louhui-hello/ESP32-S3_Clock/docs/README.md

# 文档 · Documentation

这个目录放的是**说明性文档**，不是设计文件。
Narrative documentation — not design files.

---

## 文件索引 · Index

| 文件 / File | 内容 / Content |
|---|---|
| [versions.md](versions.md) | 板子版本演进（V1 → V3.0） |
| [soldering.md](soldering.md) | 焊接顺序、热板参数、检查清单 |
| `images/` | 3D 渲染、实物照、原理图截图 |

---

## 待补 · TODO

- [ ] V2 的记录（如果有）
- [ ] 引脚定义表 `pinout.md`
- [ ] 电源设计说明 `power.md`
- [ ] 第一次上电的测试记录
- [ ] `images/` 里的图片

---

## 写文档的约定 · Conventions

```
✅ 中英双语，先中后英
✅ 每条建议都写理由，不只写"推荐"
✅ 已知问题写成表格，带"计划"
✅ 图片放 images/，用相对路径引用
```
