louhui-hello/ESP32-S3_Clock/docs/versions.md

# 版本演进 · Version History

板子本体的迭代记录，不是文件格式版本。
Board revisions — not file format versions.

---

## 总览 · Overview

| 板子版本 / Board | 主控 / MCU | 层数 | 关键变化 / Key Change | 状态 |
|---|---|---|---|---|
| V1 | STC15 | 2 | 第一版 | ❌ 文件已丢失 |
| V1.5 | ESP8266（ESP-12F） | 2 | 换成 WiFi 方案 | ✅ 有仿真图 |
| V2 | ? | ? | 待补 | ❓ |
| **V3.0** | **ESP32-S3-WROOM-1** | **4** | **加充电 + 降压 + 电池** | ✅ **当前** |

> ⚠️ 注意区分：`hardware/Project_Files/Project_EasyEDA/v2` 和 `v3` 是**文件格式**，
> 不是板子版本。两份内容相同，只是 `.epro` 与 `.epro2` 两种容器。

---

## V3.0（2026-10-17 下单）

**关键变化**

- 主控升级为 **ESP32-S3-WROOM-1-N16R8**
- 从 2 层升到 **4 层**，叠层改为 信号 / GND / 3V3 / 信号
- 电源链完整化：**TP4056 充电 + TLV62568 降压**
  - 替换掉旧方案的 AMS1117（压差大、静态电流高）
- 增加 **CR1220 备电**，RTC 掉电不丢时间
- 增加 **AT24C02**，存闹钟和配置
- 板载 **无源蜂鸣器**（PWM 驱动）
- 4 键 + RST + BOOT
- TP4056 加 **散热焊盘 + 6 个散热过孔**

**交付参数**

- 尺寸 81.915 × 72.263 mm
- 4 层，1.6 mm，OSP，蓝色阻焊
- DRC 0 错误

**生产记录**

| 步骤 | 时间 |
|---|---|
| 下单 | 2026-10-17 02:14 |
| 层压 | 2026-10-17 23:23 |
| 钻孔 | 2026-10-18 04:51 |
| 沉铜 | 2026-10-18 06:07 |
| 预计发货 | 2026-10-20 |

**上电实测（2026-10-26）**

| 项目 | 结果 | 说明 |
|---|---|---|
| I2C 扫描 | 0x3C / 0x50 / 0x68 | OLED、AT24C02、DS3231 全部响应 |
| DS3231 | ✅ 正常 | 片内温度 30.75 °C，秒寄存器递增 |
| RTC 时间 | ❌ 未设置 | 读回 2000-01-01，状态寄存器 OSF=1 |
| CR1220 备电 | ❌ 待修 | 电池座负极下方缺 GND 铺铜，电池短路鼓包，重新购买 |

> 测试工具：`tools/i2c_scan`（总线扫描）、`tools/rtc_probe`（RTC 识别 + 走时检测）。

---

## V1.5（2026-10-12 下单）

**方案**

- ESP8266（ESP-12F 模组）
- 2 层板，绿色阻焊
- 3 个 LED、3 个按键
- 一个圆形电池座
- 4P 排针（外接 OLED）
- 2P 排针

**板号**：`13226789A_Y6_261012`

**局限**

- 无板上显示，OLED 靠排针外接
- 无充电管理
- 无 RTC

---

## V1（已丢失）

- STC15 方案
- 2 层板
- 细节已无法考证

---

## 待办 · TODO

- [ ] 补 V2 的记录
- [ ] 补 V1 的照片（如果有）
- [ ] 每版存一张 3D 渲染图到 `docs/images/`
