louhui-hello/ESP32-S3_Clock/tools/README.md

# 工具 · Tools

辅助脚本，不是项目本体。
Helper scripts — not part of the firmware or hardware.

---

## 目录 · Contents

```
tools/
└── flash_tools/     烧录相关 / flashing helpers
```

---

## TODO

- [ ] ESP-IDF 一键构建 + 烧录脚本
- [ ] 串口日志抓取脚本
- [ ] 量产测试脚本

---

## 说明 · Note

这里的脚本默认 **不依赖第三方库**，能跑就行。
Scripts here should stay dependency-free.
