louhui-hello/ESP32-S3_Clock/legacy/old_repo/docs/README.md

<!--
文档与图片：Copyright (C) 2026 louhui, licensed under CC-BY-SA-4.0
-->

# docs

- `images/` ：原理图、PCB、实物照片
