louhui-hello/ESP32-S3_Clock/hardware/PCB/BOM/BOM_Board1_Schematic1_2026-10-18.xlsx

No. | Quantity | Comment | Designator | Footprint | Value | Manufacturer Part | Manufacturer | Supplier Part | Supplier
1 | 1 | AT24C02 | AT24C02_EEPROM | SOP-8_L5.0-W4.0-P1.27-LS6.0-BL |  | AT24C02 | IDCHIP(英锐芯) | C688857 | LCSC
2 | 1 | LAIL-CR1220-MO-02 | BT1 | BAT_TH_LAIL-CR1220-MO-02 |  | LAIL-CR1220-MO-02 | LAILAN(莱联) | C55318146 | LCSC
3 | 2 | 22uF | C1,C9 | C1210 | 22uF | CL32A226KAJNNNE | SAMSUNG(三星) | C52306 | LCSC
4 | 3 | 100nF | C2,C4,C7 | C0805 | 100nF | CL21B104KBCNNNC | SAMSUNG(三星) | C1711 | LCSC
5 | 1 | 22uF | C3 | C0805 | 22uF | HGC0805R5226M250NSLJ | Chinocera(华瓷) | C33546009 | LCSC
6 | 3 | 100nF | C5,C6,C8 | C0805 | 100nF | CC0805KRX7R9BB104 | YAGEO(国巨) | C49678 | LCSC
7 | 2 | 10uF | C10,C11 | C0805 | 10uF | CL21A106KAYNNNE | SAMSUNG(三星) | C15850 | LCSC
8 | 1 | 1N4148W | D1 | SOD-123_L2.7-W1.6-LS3.7-FD |  | 1N4148W | R+O(宏嘉诚) | C7420318 | LCSC
9 | 1 | SS34 | D2 | SMC_L6.9-W5.9-LS7.9-RD |  | SS34 | onsemi(安森美) | C154551 | LCSC
10 | 1 | LAIL-PZ2.54-3P-L | H1 | HDR-TH_3P-P2.54-V-M-1 |  | LAIL-PZ2.54-3P-L | LAILAN(莱联) | C54950604 | LCSC
11 | 1 | LAIL-PZ2.54-4P-L | H2 | CONN-TH_LAIL-PZ2.54-4P-L |  | LAIL-PZ2.54-4P-L | LAILAN(莱联) | C54950602 | LCSC
12 | 1 | DH0520H-2R2M | L1 | IND-SMD_L5.6-W5.2_MST0530H-150M |  | DH0520H-2R2M | DH(德鸿感应) | C41407019 | LCSC
13 | 1 | GL0805UG01 | LED3 | LED0805-FD_GL0805UG01 |  | GL0805UG01 | Guiguang light(桂光光电) | C51933308 | LCSC
14 | 1 | GL0805UR01 | LED4 | LED0805-R-RD_RED |  | GL0805UR01 | Guiguang light(桂光光电) | C51933307 | LCSC
15 | 1 | MicroXNJ | MicroUSB | MICRO-USB-SMD_MICROXNJ_1 |  | MicroXNJ | SHOU HAN(首韩) | C404969 | LCSC
16 | 1 | ZX-MX1.25-2PWZ | MX1.25电池连接器 | CONN-TH_2P-P1.25_ZX-MX1.25-2PWZ |  | ZX-MX1.25-2PWZ | Megastar(兆星) | C7430463 | LCSC
17 | 1 | S8050 | Q1 | SOT-23-3_L2.9-W1.3-P1.90-LS2.3-BR |  | S8050 | R+O(宏嘉诚) | C20069125 | LCSC
18 | 1 | AO3401A | Q2 | SOT-23_L2.9-W1.3-P1.90-LS2.4-BR |  | AO3401A | AOS | C15127 | LCSC
19 | 4 | 10kΩ | R1,R2,R3,R5 | R0603 | 10kΩ | FRC0603F1002TS | FOJAN(富捷) | C2906982 | LCSC
20 | 2 | 0Ω | R6,R16 | R1206 | 0Ω | RE1206F1R000 | JIERR(捷而瑞) | C46961765 | LCSC
21 | 2 | 4.7kΩ | R7,R8 | R0603 | 4.7kΩ | 0603WAF4701T5E | UNI-ROYAL(厚声) | C23162 | LCSC
22 | 1 | 2.4kΩ | R9 | R0603 | 2.4kΩ | FRC0603F2401TS | FOJAN(富捷) | C2907007 | LCSC
23 | 2 | 100kΩ | R10,R14 | R0805 | 100kΩ | 0805W8F1003T5E | UNI-ROYAL(厚声) | C149504 | LCSC
24 | 1 | 22kΩ | R11 | R0805 | 22kΩ | FRC0805F2202TS | FOJAN(富捷) | C2907243 | LCSC
25 | 2 | 1kΩ | R12,R13 | R0805 | 1kΩ | 0805W8F1001T5E | UNI-ROYAL(厚声) | C17513 | LCSC
26 | 1 | 1kΩ | R15 | R0603 | 1kΩ | FRC0603F1001TS | FOJAN(富捷) | C2907002 | LCSC
27 | 5 | TS-1101-C-W | SW2,SW3,SW4,SW5,SW6 | SW-SMD_L6.0-W3.3-LS8.0_TS-1101-C-W |  | TS-1101-C-W | XKB Connection(中国星坤) | C318938 | LCSC
28 | 1 | TLV62568DBVR | TLV62568_BUCK | SOT-23-5_L3.0-W1.7-P0.95-LS2.8-BR |  | TLV62568DBVR | TI(德州仪器) | C163219 | LCSC
29 | 1 | TP4056 | TP4056 | ESOP-8_L4.9-W3.9-P1.27-LS6.0-BL-EP |  | TP4056 | UMW(友台半导体) | C725790 | LCSC
30 | 1 | 2.4GHz | U2 | WIRELM-SMD_ESP32-S3-WROOM-1 | 2.4GHz | ESP32-S3-WROOM-1-N16R8 | ESPRESSIF(乐鑫) | C2913202 | LCSC
31 | 1 | DS3231MZ+TRL | U3 | SOIC-8_L4.9-W3.9-P1.27-LS6.0-BL |  | DS3231MZ+TRL | ADI(亚德诺)/MAXIM(美信) | C107410 | LCSC
32 | 1 | LAIL-PM2.54-4P-L | U4 | HDR-TH_4P-P2.54-V-F |  | LAIL-PM2.54-4P-L | LAILAN(莱联) | C54973823 | LCSC
33 | 1 | 2.7kHz | 无源蜂鸣器 | BUZ-TH_BD9.0-P4.00-D0.6-FD | 2.7kHz | QMB-09B-03 | 华能 | C96256 | LCSC
