louhui-hello/ESP32-S3_Clock/legacy/old_repo/hardware/BOM.md

# 物料清单 BOM — ESP32-S3 桌面闹钟 V3.0

> **数据来源**：立创商城订货合同 `SO2610171717`（2026-10-17，甲方：娄辉）
> **采购分两处**：主控模组走淘宝（立创无货且淘宝更便宜），其余全部立创商城。

---

## 一、立创商城下单明细（32 项，实际成交价）

| # | 型号 | 封装 | 参数 | 数量 | 立创编号 | 位号 | 金额(¥) |
|---|---|---|---|---|---|---|---|
| 1 | **0603WAF4701T5E** | 0603 | 4.7kΩ ±1% 100mW | 100 | C23162 | R7 R8 | 1.62 |
| 2 | **TP4056** | ESOP-8 | 1A 线性锂电充电器 | 5 | C725790 | U6 | 2.73 |
| 3 | **CL21A106KAYNNNE** | 0805 | 10µF ±10% 25V | 20 | C15850 | C10 C11 | 5.16 |
| 4 | **LAIL-PZ2.54-4P-L** | 插件 | 1x4P 2.54mm 方针 | 20 | C54950602 | H2 | 4.55 |
| 5 | **MicroXNJ** | SMD | Micro-B 母座 卧贴 | 10 | C404969 | USB1 | 2.52 |
| 6 | **SS34** | SMC | 40V 3A 肖特基 | 1 | C154551 | D2 | 3.45 |
| 7 | **RE1206F1R000** | 1206 | 0Ω 1W ±1% | 10 | C46961765 | R6 R16 | 3.04 |
| 8 | **CL32A226KAJNNNE** | 1210 | 22µF ±10% 25V | 2 | C52306 | C1 C9 | 2.88 |
| 9 | **TLV62568DBVR** | SOT-23-5 | 降压 1A 2.5~5.5V | 5 | C163219 | U7 | 2.24 |
| 10 | **1N4148W** | SOD-123 | 100V 150mA | 50 | C7420318 | D1 | 2.08 |
| 11 | **HGC0805R5226M250NSLJ** | 0805 | 22µF ±20% 25V | 5 | C33546009 | C3 | 4.24 |
| 12 | **FRC0603F1002TS** | 0603 | 10kΩ ±1% 100mW | 100 | C2906982 | R1 R2 R3 R5 | 1.11 |
| 13 | **AO3401A** | SOT-23 | P沟道 30V 4A | 5 | C15127 | Q2 | 3.00 |
| 14 | **0805W8F1001T5E** | 0805 | 1kΩ ±1% 125mW | 100 | C17513 | R12 R13 | 2.02 |
| 15 | **GL0805UR01** | 0805 | 红色 高亮 | 100 | C51933307 | LED4 | 2.92 |
| 16 | **FRC0603F1001TS** | 0603 | 1kΩ ±1% 100mW | 100 | C2907002 | R15 | 1.18 |
| 17 | **GL0805UG01** | 0805 | 翠绿 高亮 | 100 | C51933308 | LED3 | 2.94 |
| 18 | **FRC0805F2202TS** | 0805 | 22kΩ ±1% 125mW | 100 | C2907243 | R11 | 1.79 |
| 19 | **LAIL-PM2.54-4P-L** | 插件 | 1x4P 2.54mm | 5 | C54973823 | U4 | 3.24 |
| 20 | **ZX-MX1.25-2PWZ** | 插件 | 1x2P 1.25mm 弯插 | 50 | C7430463 | U8 | 4.09 |
| 21 | **CL21B104KBCNNNC** | 0805 | 100nF ±10% 50V | 20 | C1711 | C2 C4 C7 | 1.78 |
| 22 | **S8050** | SOT-23 | NPN 500mA 25V | 50 | C20069125 | Q1 | 3.53 |
| 23 | **QMB-09B-03** | 插件 D9mm | 无源蜂鸣器 | 5 | C96256 | BUZZER1 | 3.86 |
| 24 | **DH0520H-2R2M** | SMD 5.6x5.2 | 2.2µH 屏蔽电感 | 5 | C41407019 | L1 | 2.55 |
| 25 | **LAIL-CR1220-MO-02** | 插件 | CR1220 电池扣 | 5 | C55318146 | BT1 | 5.84 |
| 26 | **AT24C02** | SOP-8 | 2Kbit EEPROM | 10 | C688857 | U5 | 3.91 |
| 27 | **CC0805KRX7R9BB104** | 0805 | 100nF ±10% 50V | 20 | C49678 | C5 C6 C8 | 2.41 |
| 28 | **LAIL-PZ2.54-3P-L** | 插件 | 1x3P 2.54mm 方针 | 20 | C54950604 | H1 | 3.64 |
| 29 | **TS-1101-C-W** | SMD 6x3.6 | 轻触开关 立贴 | 10 | C318938 | SW2~SW6 | 2.59 |
| 30 | **DS3231MZ+TRL** | SOIC-8 | 高精度 RTC | 1 | C107410 | U3 | 20.84 |
| 31 | **FRC0603F2401TS** | 0603 | 2.4kΩ ±1% 100mW | 100 | C2907007 | R9 | 1.25 |
| 32 | **0805W8F1003T5E** | 0805 | 100kΩ ±1% 125mW | 100 | C149504 | R10 R14 | 3.46 |
| | | | | | | **商品合计（含税）** | **112.46** |
| | | | | | | 运费 | 8.00 |
| | | | | | | **订单总计** | **120.46** |

> **说明**：立创商城对个人买家按 13% 增值税计价（未税 99.52 + 税 12.94 = 112.46）。
> 上表金额为**含税实付**。

### 最小包装说明

立创对小批量有最小包装，很多东西一买就是 100 个：

| 类别 | 最小包装 | 实际用量 |
|---|---|---|
| 0603 / 0805 电阻 | **100 个** | 1~4 个 |
| 0402~0805 电容 | 20 个 | 2~3 个 |
| LED | **100 个** | 1 个 |
| 二极管 / 三极管 | 50 个 | 1 个 |
| 排针 / 连接器 | 20 个 | 1 个 |

**多出来的全是备件**，以后做别的板子能接着用，不是浪费。

---

## 二、淘宝待买

| 项目 | 型号 | 数量 | 单价(¥) | 小计(¥) | 说明 |
|---|---|---|---|---|---|
| **主控模组** | **ESP32-S3-WROOM-1-N16R8** | 1 | **22.00** | **22.00** | 立创商城 C2913202 配单无匹配，走淘宝「优信电子」 |
| OLED 屏 | 0.91 寸 128×32 I2C（SSD1306） | 1 | 约 8.00 | 8.00 | |
| RTC 电池 | CR1220（3V 锂锰，**不可充**） | 1 | 约 2.00 | 2.00 | |
| 主电池 | 软包锂电 1000mAh（带保护板，MX1.25 插头） | 1 | 约 12.00 | 12.00 | 503450 尺寸 |
| | | | | **约 ¥44** | 另计运费 |

> **电池可以延后买**：调试阶段只插 USB 就能跑，等板子验证通过再买电池。

---

## 三、总账

| 项目 | 金额(¥) |
|---|---|
| 立创商城（32 项，含税 + 运费） | 120.46 |
| 淘宝（S3 模组 + OLED + 电池） | 约 44.00 |
| 淘宝运费 | 约 5.00 |
| **PCB 打样（4 层 ×5 片，OSP 券免费）** | **0.00** |
| **合计** | **约 ¥169** |

**其中"必须花"的：**
- DS3231（¥20.84）+ EPS32-S3（¥22）= **¥42.84**，占 25%
- 这两颗是项目核心，**不能省**

**可以延后的：**
- 软包电池 ¥12 + CR1220 ¥2 = ¥14（调试阶段用 USB 供电）

---

## 四、位号对照表（原理图 → 实物）

| 位号 | 型号 | 作用 |
|---|---|---|
| **U2** | ESP32-S3-WROOM-1-N16R8 | 主控 |
| **U3** | DS3231MZ+TRL | 高精度 RTC |
| **U5** | AT24C02 | 2Kbit EEPROM（存设置） |
| **U6** | TP4056 | 锂电池充电 |
| **U7** | TLV62568DBVR | 3.3V 降压（buck） |
| **U8** | ZX-MX1.25-2PWZ | 电池连接器（卧式弯针） |
| **U4** | LAIL-PM2.54-4P-L | OLED 排针 |
| **H1** | LAIL-PZ2.54-3P-L | UART 排针 |
| **H2** | LAIL-PZ2.54-4P-L | I2C 扩展排针 |
| **Q1** | S8050 | 蜂鸣器驱动（NPN） |
| **Q2** | AO3401A | 负载分配（P-MOS） |
| **D1** | 1N4148W | 蜂鸣器续流二极管 |
| **D2** | SS34 | USB 通路 + 防倒灌 |
| **L1** | DH0520H-2R2M | buck 储能电感 2.2µH |
| **BT1** | CR1220 电池扣 | RTC 后备电池 |
| **BUZZER1** | QMB-09B-03 | **无源**蜂鸣器（需 PWM 驱动） |
| **LED3 / LED4** | GL0805UG01 / GL0805UR01 | 绿=满电 / 红=充电中 |
| **SW2~SW6** | TS-1101-C-W | BOOT / 三按键 / RST |
| **USB1** | MicroXNJ | Micro-USB 座 |
| R1 R2 R3 R5 R9 R15 | 10k / 2.4k / 1k | 上拉、PROG、基极限流 |
| R10 R11 R14 | 100k / 22k / 100k | buck 分压、栅极下拉 |
| R12 R13 | 1kΩ | LED 限流 |
| R6 R16 | 0Ω | RTC 串联 / 电池电流测试点 |
| R7 R8 | 4.7kΩ | I2C 上拉 |

---

## 五、关键设计参数（V3.0）

| 项 | 值 |
|---|---|
| 板框 | 81.91 × 72.26 mm，四角圆角 R3 |
| 叠层 | **4 层**：信号 / GND / 3.3V / 信号 |
| 铜厚 | 外层 1oz，内层 0.5oz |
| 工艺 | OSP（免清洗） |
| 最小孔径 | 0.3 mm |
| 走线 | 424 段，全在顶层 |
| 过孔 | 86 个 |
| **DRC** | **0 错误** |

### 供电架构

```
USB 5V ── VBUS ──┬── U6 TP4056 ── 电池
                 ├── D2 (SS34) ──┐
                 └── Q2 栅极      │
   电池 ──────── Q2 (AO3401) ─────┴── VIN ── U7 buck ── 3.3V
```

**特性**：USB 和电池自动切换；充电时电池被隔离（不会边充边放）；深睡约 20µA。

---

## 六、给家长看的三个重点

1. **PCB 免费**：有「2~6 层 OSP 免费」券，正常 4 层 5 片要 ¥50，这次 **0 元**；
2. **不量产、不上 SMT**：自己做 **5 片**，全部手焊，**省掉约 ¥50 的贴片费**；
3. **有一大半是备件**：立创按最小包装卖（电阻 100 只、排针 20 根…），用不完的下次继续用。
