louhui-hello/ESP32-S3_Clock/hardware/STEP/README.md

# 3D 模型 · 3D Model

给外壳设计用的 STEP 文件。
STEP files for enclosure design.

---

## 状态 · Status

> 🚧 待补 — 从立创EDA 导出后放这里。
> 🚧 TODO — export from EasyEDA Pro and drop the file here.

---

## 如何导出 · How to Export

```
立创EDA Pro → 打开工程 → 文件 → 导出 → STEP
→ 存成 esp32s3_clock_v3.step
```

---

## 外壳尺寸参考 · Enclosure Reference

```
PCB:      81.9 × 72.3 × 1.6 mm
最高元件:  约 6 mm（背面）
21700:     Ø21 × 70 mm（含保护板 Ø23.5）

建议外壳内腔: 85 × 75 × 35 mm
```
