louhui-hello/ESP32-S3_Clock/hardware/PCB/PCB_PCB1_2026-10-18.pdf

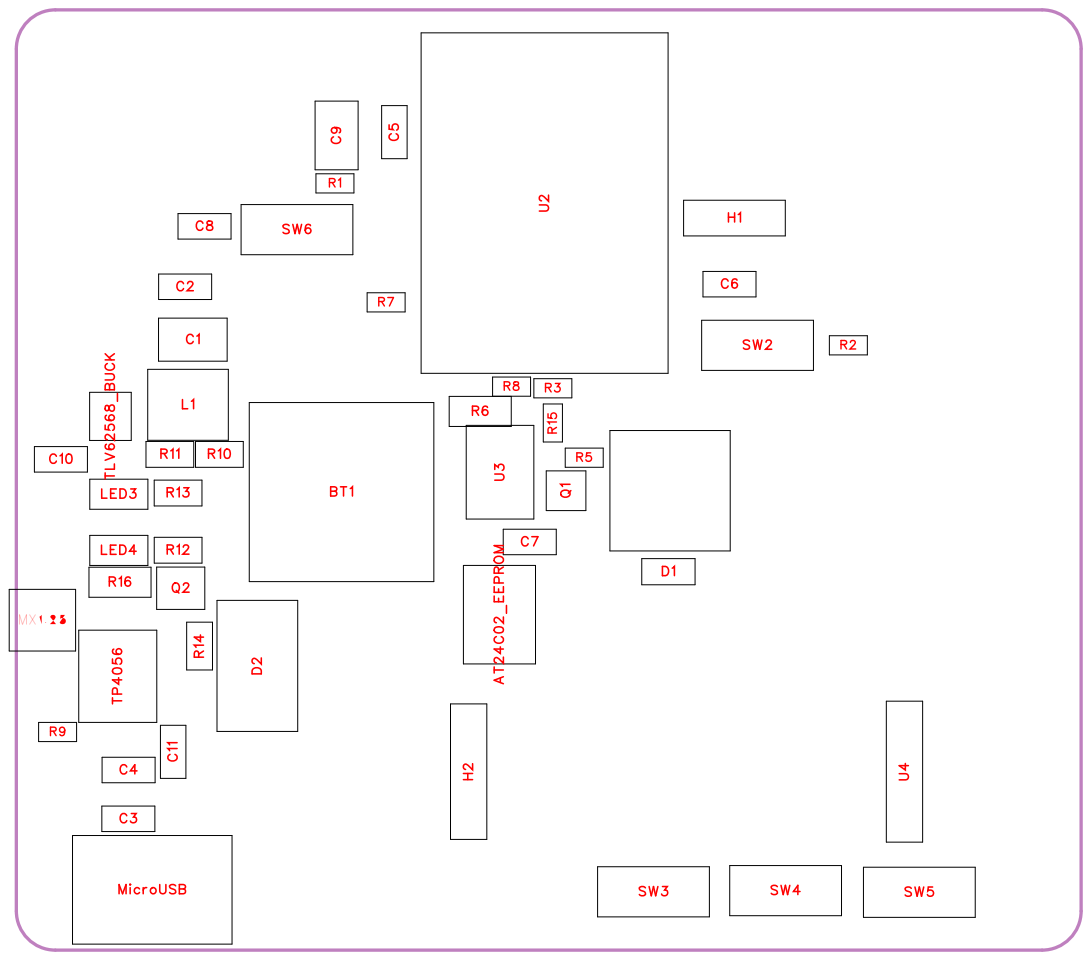
[picture p1: page 1]

No. | Quantity | Comment | Designator | Footprint | Value | Manufacture r Part | Manufacture r | Supplier Part | Supplier
1 | 1 | AT24C02 | AT24C02_EEPROM | SOP-8_L5.0-W4.0-P1.27-LS6.0-BL | | AT24C02 | IDCHIP(ñ¯) | C688857 | LCSC
2 | 1 | LAIL-CR1220 -MO-02 | BT1 | BAT_TH_LAIL -CR1220-MO-02 | | LAIL-CR1220 -MO-02 | LAILAN(±T) | C55318146 | LCSC
3 | 2 | 22uF | C1,C9 | C1210 | 22uF | CL32A226KAJ NNNE | SAMSUNG( ) C52306 | | LCSC
4 | 3 | 100nF | C2,C4,C7 | C0805 | 100nF | CL21B104KBC NNNC | SAMSUNG( ) C1711 | | LCSC
5 | 1 | 22uF | C3 | C0805 | 22uF | HGC0805R522 6M250NSLJ | Chinocera(N) Tj | T* (÷) C33546009 | LCSC
6 | 3 | 100nF | C5,C6,C8 | C0805 | 100nF | CC0805KRX7R 9BB104 | YAGEO(ýè) | C49678 | LCSC
7 | 2 | 10uF | C10,C11 | C0805 | 10uF | CL21A106KAY NNNE | SAMSUNG( ) C15850 | | LCSC
8 | 1 | 1N4148W | D1 | SOD-123_L2. 7-W1.6-LS3. 7-FD | | 1N4148W | R+O(• Ú) | C7420318 | LCSC
9 | 1 | SS34 | D2 | SMC_L6.9-W5 .9-LS7.9-RD | | SS34 | onsemi(‰îŽ) | C154551 | LCSC
10 | 1 | LAIL-PZ2.54 -3P-L | H1 | HDR-TH_3P-P 2.54-V-M-1 | | LAIL-PZ2.54 -3P-L | LAILAN(±T) | C54950604 | LCSC
11 | 1 | LAIL-PZ2.54 -4P-L | H2 | CONN-TH_LAI L-PZ2.54-4P -L | | LAIL-PZ2.54 -4P-L | LAILAN(±T) | C54950602 | LCSC
12 | 1 | DH0520H-2R2 M | L1 | IND-SMD_L5. 6-W5.2_MST0 530H-150M | | DH0520H-2R2 M | DH(·?”) | C41407019 | LCSC
13 | 1 | GL0805UG01 LED3 | | LED0805-FD_ GL0805UG01 | | GL0805UG01 | Guiguang light(BII5) | C51933308 | LCSC
14 | 1 | GL0805UR01 | LED4 | LED0805-R-R D_RED | | GL0805UR01 | Guiguang light(BII5) | C51933307 | LCSC
15 | 1 | MicroXNJ | MicroUSB | MICRO-USB-S MD_MICROXNJ _1 | | MicroXNJ | SHOU HAN(–é) | C404969 | LCSC
16 | 1 | ZX-MX1.25-2 PWZ | MX1.255`Þ¥h | CONN-TH_2P-P1.25_ZX-MX 1.25-2PWZ | | ZX-MX1.25-2 PWZ | Megastar(F) Tj | T* () C7430463 | LCSC
17 | 1 | S8050 | Q1 | SOT-23-3_L2 .9-W1.3-P1. 90-LS2.3-BR | | S8050 | R+O(• Ú) | C20069125 | LCSC
18 | 1 | AO3401A | Q2 | SOT-23_L2.9 -W1.3-P1.90 -LS2.4-BR | | AO3401A | AOS | C15127 | LCSC
19 | 4 | 10k© | R1,R2,R3,R5 | R0603 | 10k© | FRC0603F100 2TS | FOJAN(Ìw) | C2906982 | LCSC

20 | 2 | 0© | R6,R16 | R1206 | 0© | RE1206F1R00 0 | JIERR(w^) | C46961765 | LCSC
21 | 2 | 4.7k© | R7,R8 | R0603 | 4.7k© | 0603WAF4701 T5E | UNI-ROYAL(š) Tj | T* (ð) C23162 | LCSC
22 | 1 | 2.4k© | R9 | R0603 | 2.4k© | FRC0603F240 1TS | FOJAN(Ìw) | C2907007 | LCSC
23 | 2 | 100k© | R10,R14 | R0805 | 100k© | 0805W8F1003 T5E | UNI-ROYAL(š) Tj | T* (ð) C149504 | LCSC
24 | 1 | 22k© | R11 | R0805 | 22k© | FRC0805F220 2TS | FOJAN(Ìw) | C2907243 | LCSC
25 | 2 | 1k© | R12,R13 | R0805 | 1k© | 0805W8F1001 T5E | UNI-ROYAL(š) Tj | T* (ð) C17513 | LCSC
26 | 1 | 1k© | R15 | R0603 | 1k© | FRC0603F100 1TS | FOJAN(Ìw) | C2907002 | LCSC
27 | 5 | TS-1101-C-W SW2,SW3,SW4,SW5,SW6 | | SW-SMD_L6.0 -W3.3-LS8.0 _TS-1101-C-W | | TS-1101-C-W | XKB Connect ion(-ýd) | C318938 | LCSC
28 | 1 | TLV62568DBV R | TLV62568_BUCK | SOT-23-5_L3 .0-W1.7-P0. 95-LS2.8-BR | | TLV62568DBV R | TI(·Þêh) | C163219 | LCSC
29 | 1 | TP4056 | TP4056 | ESOP-8_L4.9 -W3.9-P1.27 -LS6.0-BL-E P | | TP4056 | UMW(ËðJüS) | C725790 | LCSC
30 | 1 | 2.4GHz | U2 | WIRELM-SMD_ ESP32-S3-WR OOM-1 | 2.4GHz | ESP32-S3-WR OOM-1-N16R8 | ESPRESSIF(P) Tj | T* (k) C2913202 | LCSC
31 | 1 | DS3231MZ+TR L | U3 | SOIC-8_L4.9 -W3.9-P1.27 -LS6.0-BL | | DS3231MZ+TR L | ADI(š·ú)/MA XIM(Žá) | C107410 | LCSC
32 | 1 | LAIL-PM2.54 -4P-L | U4 | HDR-TH_4P-P 2.54-V-F | | LAIL-PM2.54 -4P-L | LAILAN(±T) | C54973823 | LCSC
33 | 1 | 2.7kHz | à•-#h | BUZ-TH_BD9. 0-P4.00-D0. 6-FD | 2.7kHz | QMB-09B-03 | Ný | C96256 | LCSC

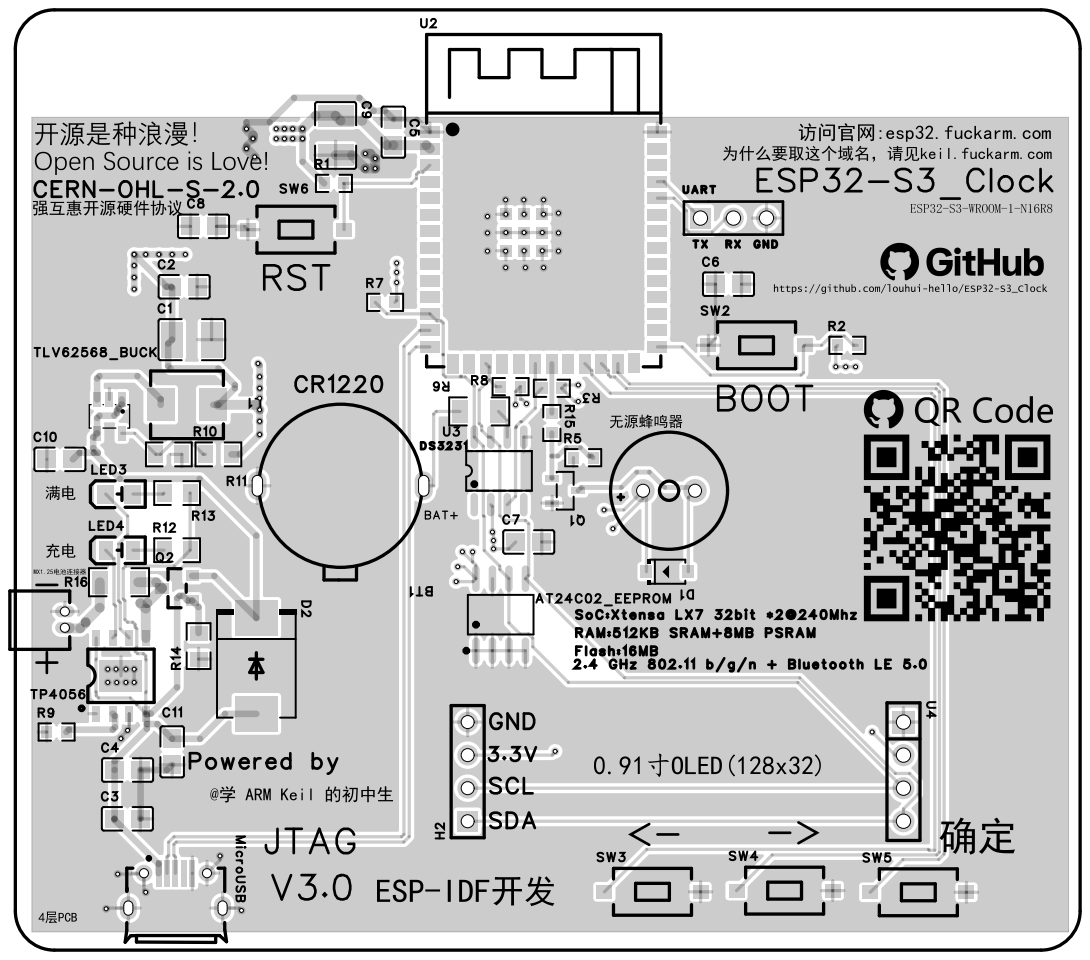
[picture p2: page 5]

Open Source is Love!
CERN-OHL-S-2.0
:àlöOfi

https://github.com/louhui-hello/ESP32-S3_Clock

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

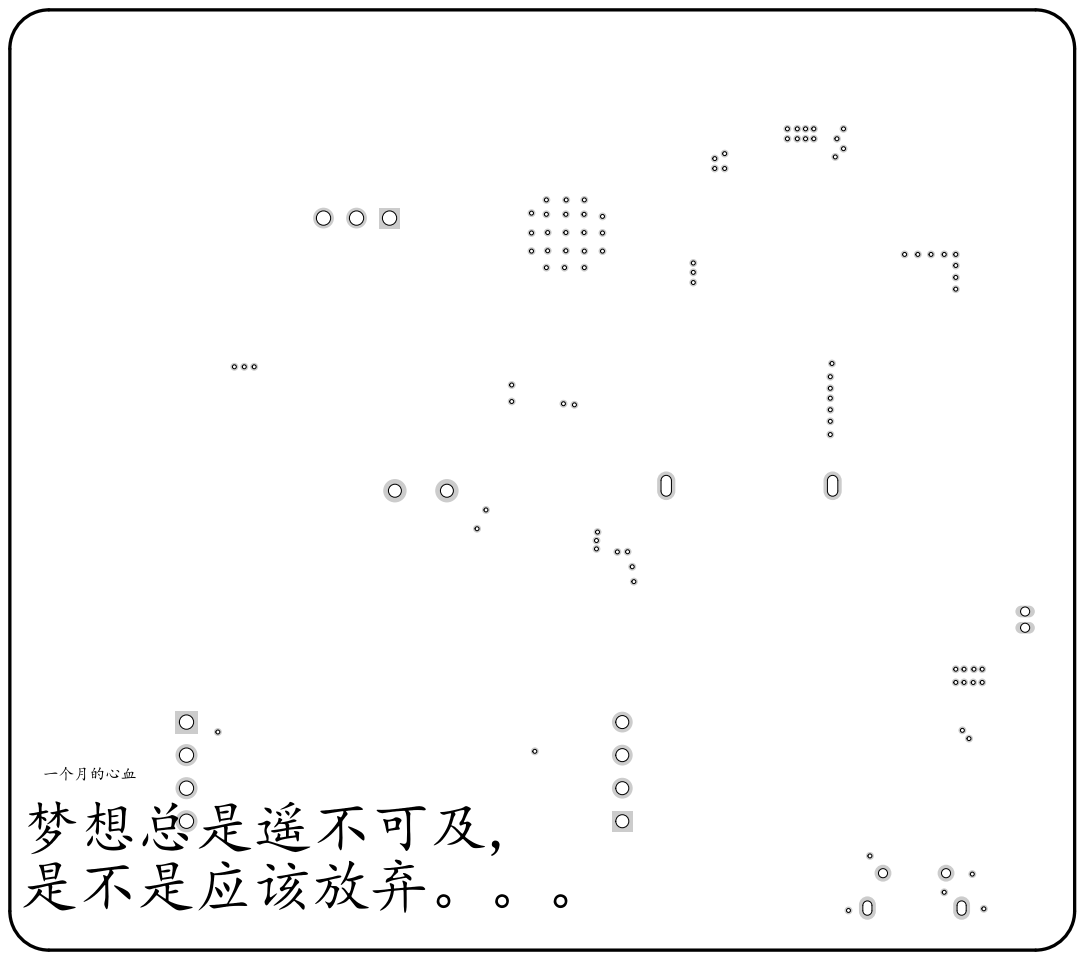
[picture p3: page 6]

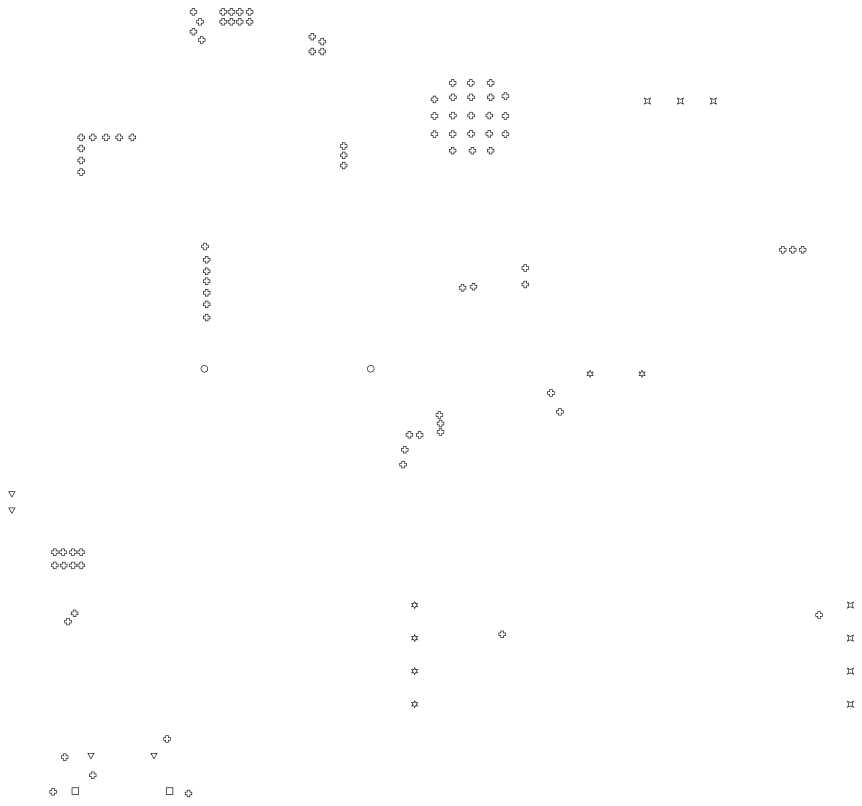
[picture p4: page 7]
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
