louhui-hello/ESP32-S3_Clock/(list of files, drawings)

Other design files:
hardware/Project_Files/Project_EasyEDA/v2/ProPrj_ESPRESSIF32-S3_CLOCK_BAT_2026-10-18.epro
