louhui-hello/ESP32-S3_Clock/(commit log)

2026-10-18 初始化仓库：V3.0 文档、硬件资料、固件占位 / init: V3.0 docs, hardware files, firmware placeholder
    [BOM_Board1_Schematic1_2026-10-18.xlsx, ProPrj_ESPRESSIF32-S3_CLOCK_BAT_2026-10-18.epro]
2026-10-18 新增 legacy/ 目录：旧版本存档 / add legacy/ for archived revisions
2026-10-18 用 .gitkeep 占位空目录 / keep empty dirs with .gitkeep
2026-10-18 legacy/ 加入旧仓库快照 open_repo / archive old open_state repo under legacy/
    [BOM.csv, BOM_立创商城_ESP32-S3_Clock.xlsx]
2026-10-18 tools: 加入 ESP32 烧录器（Qt6/QML 单文件版 + 源码）与 bin 合并脚本
2026-10-24 tools/oled_rtc: u8g2 时钟固件（NTP 对时 + 按键闹钟 + 网页上传 MIDI 旋律 + 蜂鸣器）
2026-10-24 docs: 添加英文版 README（完整硬件/固件/API/已知问题/路线图）
2026-10-26 tools: 新增 I2C 扫描与 RTC 探针（验证 0x3C/0x50/0x68 与 DS3231 走时）
2026-10-26 docs: 添加 v3.0.0 发布说明
2026-10-26 flasher: 静态 Qt 单文件版（嵌入 esptool，qrc 资源 + 首次运行解出）
